duodiscus92/projet-cobalt/kicad/cobalt/fabrication/repartiteur-3D.png

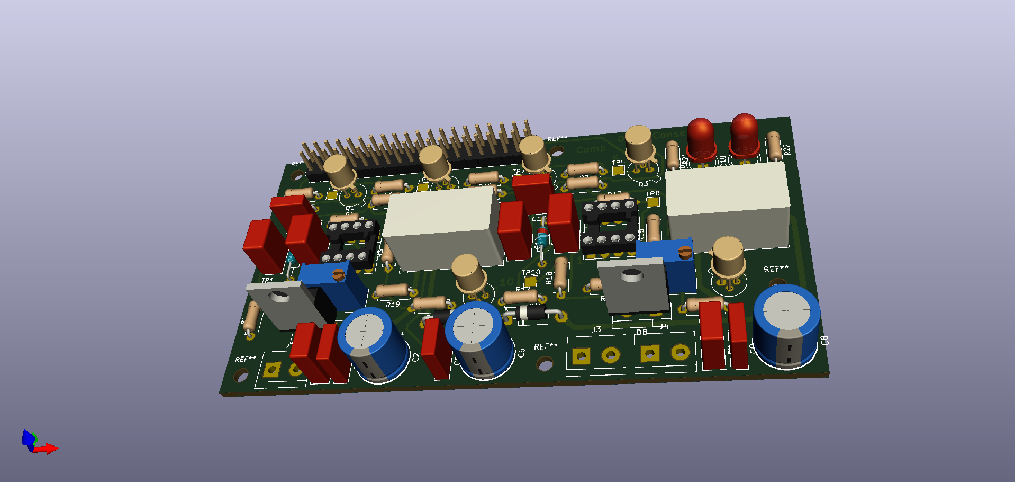
kicad/cobalt/fabrication/repartiteur-3D.png
