duodiscus92/projet-cobalt/kicad/cobalt/fabrication/ci-reel.png

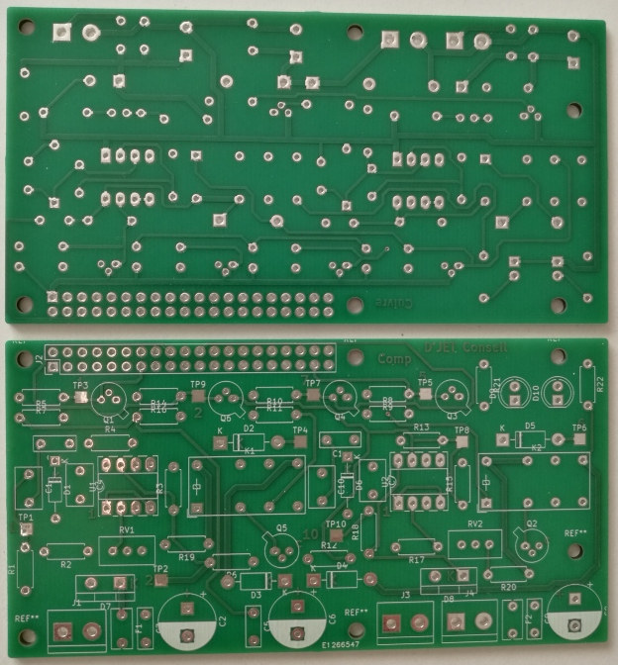
kicad/cobalt/fabrication/ci-reel.png
