duodiscus92/projet-cobalt/kicad/cobalt/repartiteur-vue1.jpg

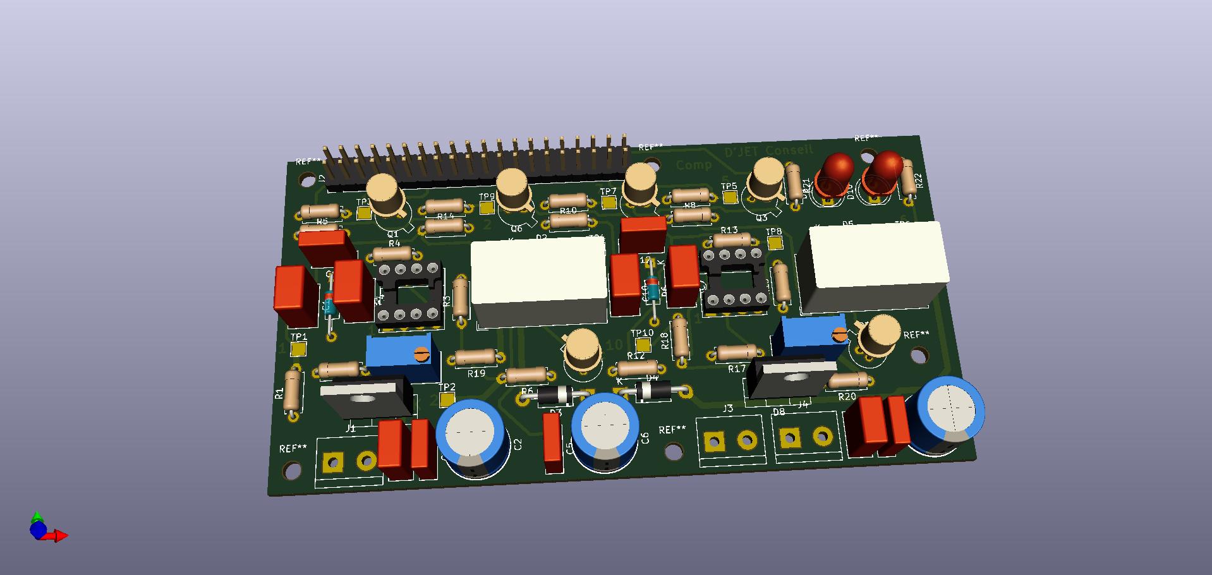
kicad/cobalt/repartiteur-vue1.jpg
