duodiscus92/projet-cobalt/kicad/cobalt/repartiteur-vue2.jpg

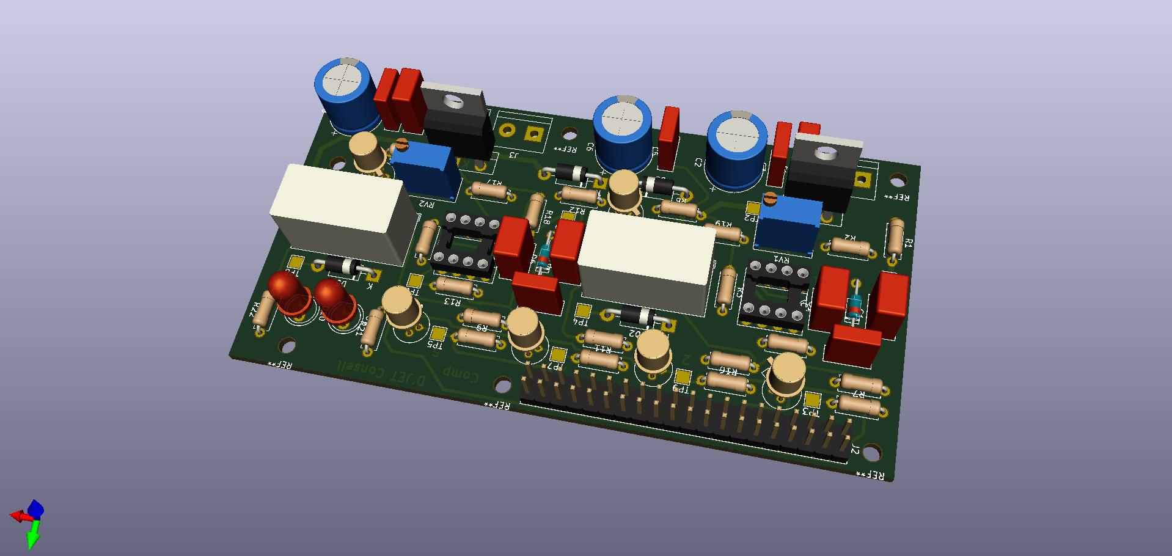
kicad/cobalt/repartiteur-vue2.jpg
