duodiscus92/projet-cobalt/kicad/cobalt/repartiteur-vue3.jpg

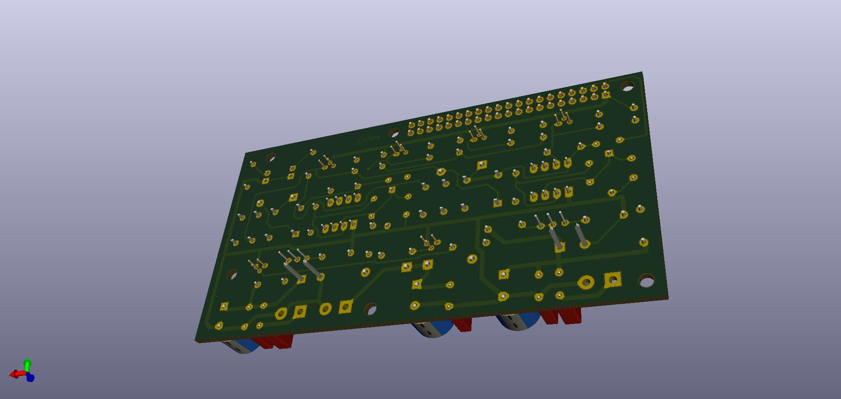
kicad/cobalt/repartiteur-vue3.jpg
