duodiscus92/projet-cobalt/kicad/cobalt/repartiteur-vue4.jpg

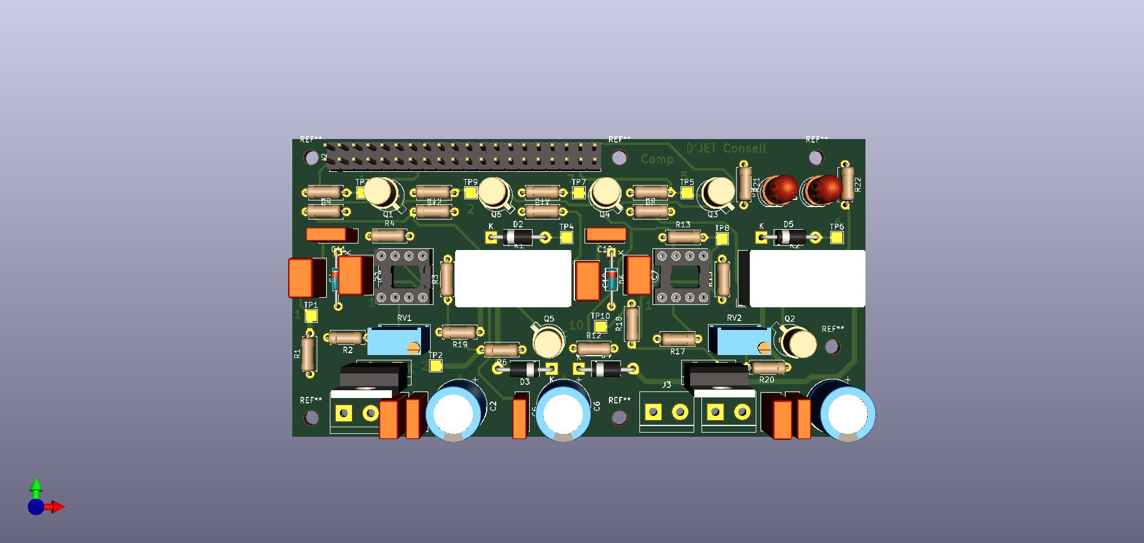
kicad/cobalt/repartiteur-vue4.jpg
