duodiscus92/projet-cobalt/kicad/cobalt/repartiteur-vue5.jpg

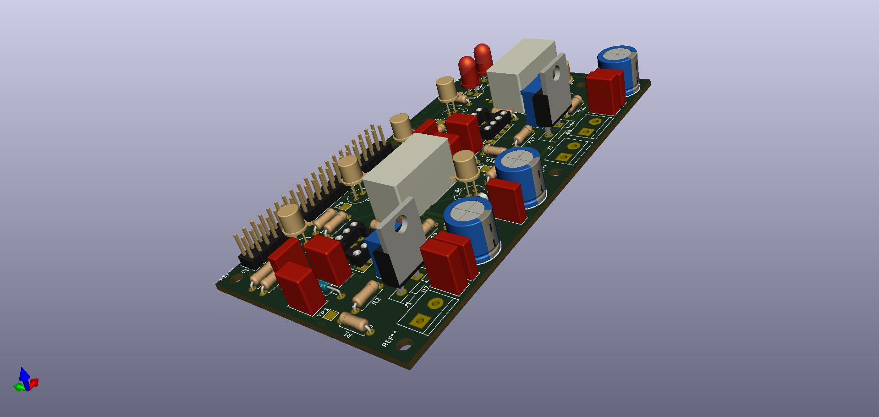
kicad/cobalt/repartiteur-vue5.jpg
