duodiscus92/projet-cobalt/kicad/cobalt/repartiteurv2-vue1.jpg

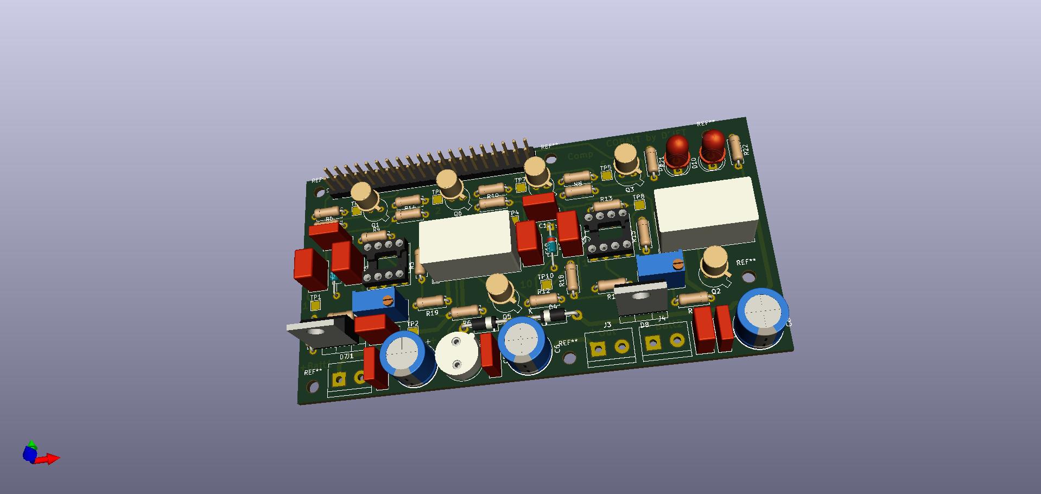
kicad/cobalt/repartiteurv2-vue1.jpg
