duodiscus92/projet-cobalt/kicad/cobalt/repartiteur.kicad_pcb

## KiCad design kicad/cobalt/repartiteur.kicad_pcb (2021-02-05)

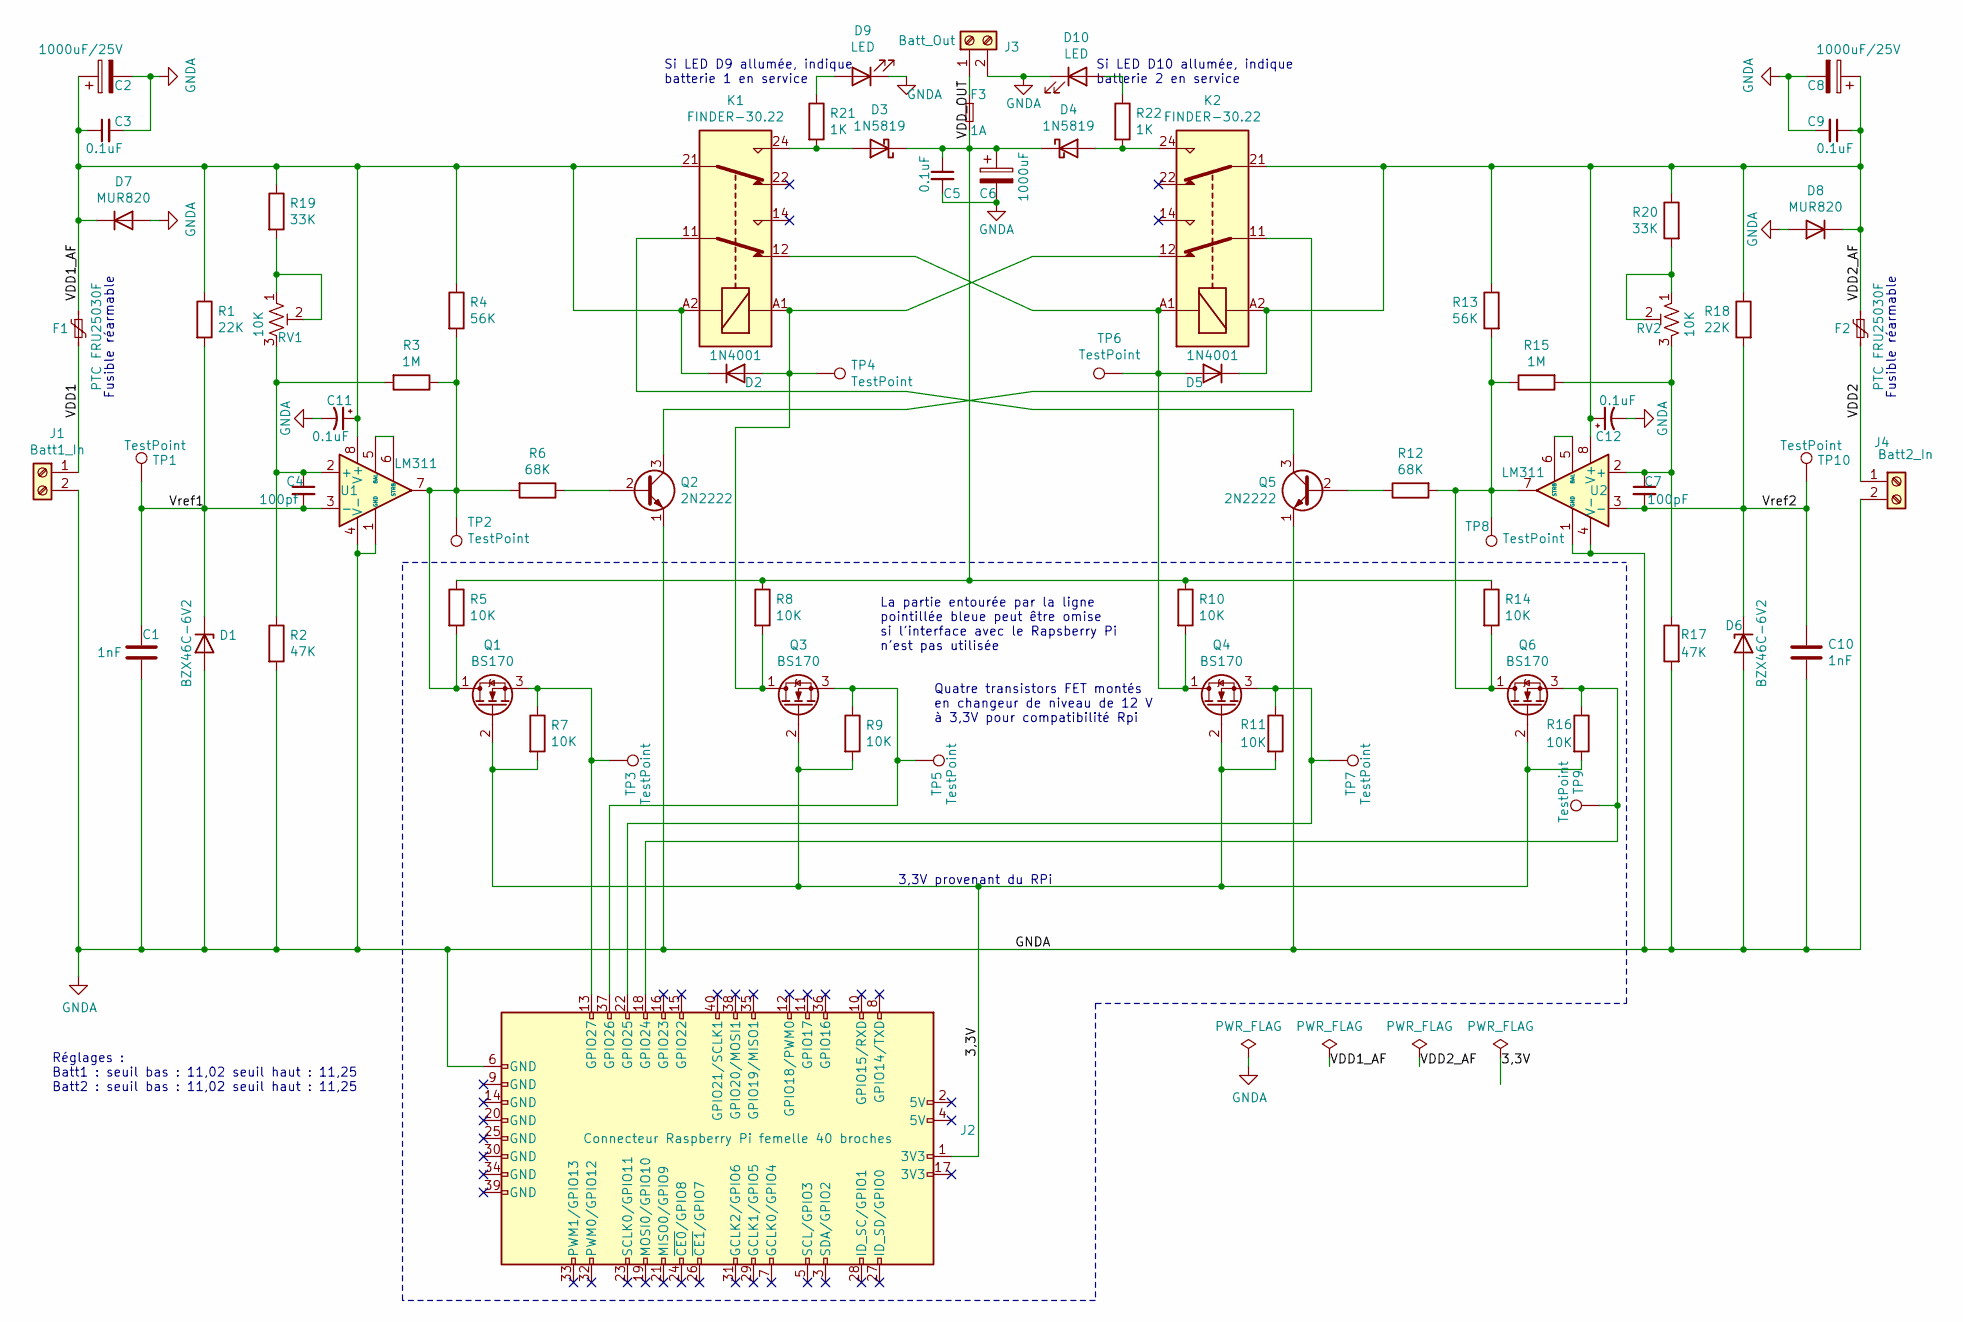
[picture p11: schematic repartiteur.sch, COBALT : Contrôleur de décharge de batteries alternée]

Parts:
C1, C10: 1nF; C_Rect_L7.2mm_W4.5mm_P5.00mm_FKS2_FKP2_MKS2_MKP2
C2, C8: 1000uF/25V; CP_Radial_D10.0mm_P5.00mm
C3, C5, C9, C11, C12: 0.1uF; C_Rect_L7.2mm_W2.5mm_P5.00mm_FKS2_FKP2_MKS2_MKP2
C4: 100pf; C_Rect_L7.2mm_W4.5mm_P5.00mm_FKS2_FKP2_MKS2_MKP2
C6: 1000uF; CP_Radial_D10.0mm_P5.00mm
C7: 100pF; C_Rect_L7.2mm_W4.5mm_P5.00mm_FKS2_FKP2_MKS2_MKP2
D1, D6: BZX46C-6V2; D_DO-35_SOD27_P10.16mm_Horizontal
D2, D5: 1N4001; D_DO-41_SOD81_P10.16mm_Horizontal
D3, D4: 1N5819; D_DO-41_SOD81_P10.16mm_Horizontal
D7, D8: MUR820; TO-220-2_Vertical
D9, D10: LED; LED_D5.0mm
F1, F2: PTC FRU25030F; C_Rect_L7.0mm_W3.5mm_P5.00mm
F3: 1A; Fuseholder_TR5_Littelfuse_No560_No460
J1: Batt1_In; TerminalBlock_bornier-2_P5.08mm
J2: Connecteur Raspberry Pi femelle 40 broches; PinHeader_2x20_P2.54mm_Vertical
J3: Batt_Out; TerminalBlock_bornier-2_P5.08mm
J4: Batt2_In; TerminalBlock_bornier-2_P5.08mm
K1, K2: FINDER-30.22; Relay_DPDT_Finder_30.22
Q1, Q3, Q4, Q6: BS170; TO-18-3
Q2, Q5: 2N2222; TO-18-3
R1, R18: 22K; R_Axial_DIN0207_L6.3mm_D2.5mm_P7.62mm_Horizontal
R2, R17: 47K; R_Axial_DIN0207_L6.3mm_D2.5mm_P7.62mm_Horizontal
R3, R15: 1M; R_Axial_DIN0207_L6.3mm_D2.5mm_P7.62mm_Horizontal
R4, R13: 56K; R_Axial_DIN0207_L6.3mm_D2.5mm_P7.62mm_Horizontal
R5, R7, R8, R9, R10, R11, R14, R16: 10K; R_Axial_DIN0207_L6.3mm_D2.5mm_P7.62mm_Horizontal
R6, R12: 68K; R_Axial_DIN0207_L6.3mm_D2.5mm_P7.62mm_Horizontal
R19, R20: 33K; R_Axial_DIN0207_L6.3mm_D2.5mm_P7.62mm_Horizontal
R21, R22: 1K; R_Axial_DIN0207_L6.3mm_D2.5mm_P7.62mm_Horizontal
RV1, RV2: 10K; Potentiometer_Bourns_3296W_Vertical
TP1, TP2, TP3, TP4, TP5, TP6, TP7, TP8, TP9, TP10: TestPoint; TestPoint_Pad_2.0x2.0mm
U1, U2: LM311; DIP-8_W7.62mm_Socket_LongPads

Connections:
/3,3V: J2.1 (3V3), Q1.2 (G), Q3.2 (G), Q4.2 (G), Q6.2 (G), R7.2, R9.2, R11.2, R16.2
/VDD1: F1.2, J1.1
/VDD1_AF: C2.1, C3.1, C11.1, D2.1 (K), D7.1 (K), F1.1, K1.21, K1.A2, R1.1, R4.1, R19.1, U1.8 (V+)
/VDD2: F2.2, J4.1
/VDD2_AF: C8.1, C9.1, C12.1, D5.1 (K), D8.1 (K), F2.1, K2.21, K2.A2, R13.1, R18.1, R20.1, U2.8 (V+)
/VDD_OUT: C5.1, C6.1, D3.1 (K), D4.1 (K), F3.2, R5.1, R8.1, R10.1, R14.1
/Vref1: C1.1, C4.2, D1.1 (K), R1.2, TP1.1, U1.3 (-)
/Vref2: C7.2, C10.1, D6.1 (K), R18.2, TP10.1, U2.3 (-)
GNDA: C1.2, C2.2, C3.2, C5.2, C6.2, C8.2, C9.2, C10.2, C11.2, C12.2, D1.2 (A), D6.2 (A), D7.2 (A), D8.2 (A), D9.1 (K), D10.1 (K), J1.2, J2.6 (GND), J3.2, J4.2, Q2.1 (E), Q5.1 (E), R2.2, R17.2, U1.1 (GND), U1.4 (V-), U2.1 (GND), U2.4 (V-)
unnamed: C4.1, R2.1, R3.2, RV1.3, U1.2 (+)
unnamed: C7.1, R15.2, R17.1, RV2.3, U2.2 (+)
unnamed: D2.2 (A), K1.A1, K2.12, Q3.1 (D), R8.2, TP4.1
unnamed: D3.2 (A), K1.24, R21.2
unnamed: D4.2 (A), K2.24, R22.2
unnamed: D5.2 (A), K1.12, K2.A1, Q4.1 (D), R10.2, TP6.1
unnamed: D9.2 (A), R21.1
unnamed: D10.2 (A), R22.1
unnamed: F3.1, J3.1
unnamed: J2.13 (GPIO27), Q1.3 (S), R7.1, TP3.1
unnamed: J2.18 (GPIO24), Q6.3 (S), R16.1, TP9.1
unnamed: J2.22 (GPIO25), Q4.3 (S), R11.1, TP7.1
unnamed: J2.37 (GPIO26), Q3.3 (S), R9.1, TP5.1
unnamed: K1.11, Q5.3 (C)
unnamed: K2.11, Q2.3 (C)
unnamed: Q1.1 (D), R3.1, R4.2, R5.2, R6.2, TP2.1, U1.7
unnamed: Q2.2 (B), R6.1
unnamed: Q5.2 (B), R12.1
unnamed: Q6.1 (D), R12.2, R13.2, R14.2, R15.1, TP8.1, U2.7
unnamed: R19.2, RV1.1, RV1.2
unnamed: R20.2, RV2.1, RV2.2
unnamed: U1.5 (BAL), U1.6 (STRB)
unnamed: U2.5 (BAL), U2.6 (STRB)

Notes on the sheet:
La partie entourée par la ligne pointillée bleue peut être omise si l'interface avec le Rapsberry Pi n'est pas utilisée
Quatre transistors FET montés en changeur de niveau de 12 V à 3,3V pour compatibilité Rpi
3,3V provenant du RPi
Réglages : Batt1 : seuil bas : 11,02 seuil haut : 11,25 Batt2 : seuil bas : 11,02 seuil haut : 11,25
Fusible réarmable
Si LED D9 allumée, indique batterie 1 en service
Si LED D10 allumée, indique batterie 2 en service

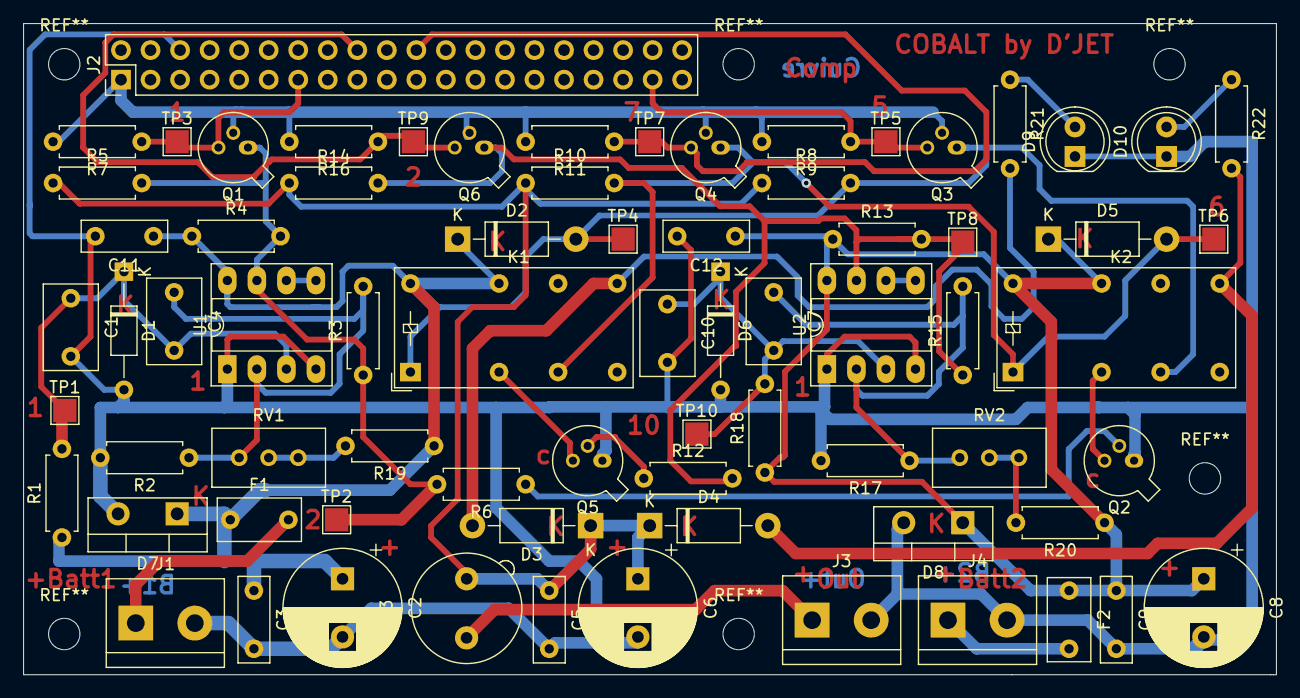
[picture p12: board repartiteur.kicad_pcb from above]

Board: 2 copper layers, 107.8 x 56.0 mm, 73 parts (0 on the bottom side), 32 nets.
