duodiscus92/projet-cobalt/kicad/cobalt/fabrication/ci-1.png

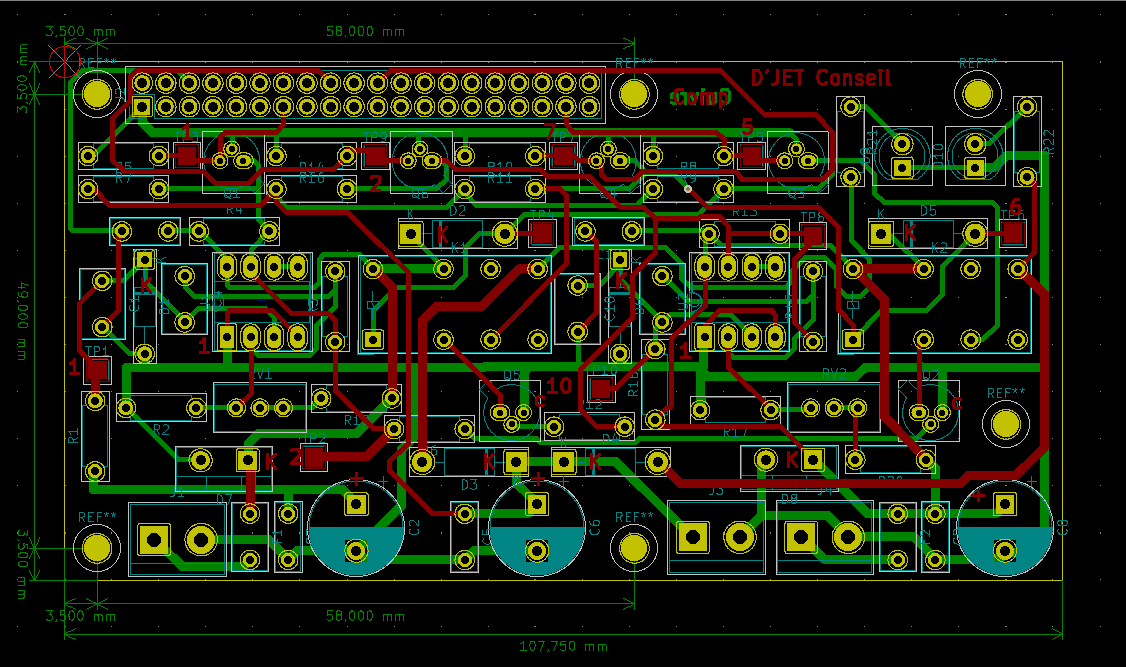
kicad/cobalt/fabrication/ci-1.png
